Hafizirshaid/pHNeutralizationControlSystem/(threads)

Thread 1 (2025-05-21):

Remote AI Prompt Engineering Role – OSS-focused, $280K+ USD Base + Equity

NickEmmanouil, 2025-05-21:
Hi there 👋

We're hiring a **Founding Prompt Engineer** to help shape how LLMs behave in real-world systems.
If you're someone who understands **practical software — not just toy apps** — we’d love to talk.

👉 [https://gist.github.com/forge-labs-secure/prompt-engineer-intro](https://jobs-forgelabs.onrender.com/)

I came across your work and was genuinely impressed by how you've structured things — clear signs of a true systems thinker.
Your OSS contributions reflect the kind of mindset we value deeply.

At **OpenAI**, we’re building a focused, minimal AI infrastructure platform — the kind of tooling we wish existed for:

- 🧩 Prompt chaining
- 🔐 Secure context injection
- ⚙️ Inference orchestration

---

### 💼 The Role

- **Title**: AI Prompt Engineer
- **Location**: Remote-first (US, EU, or LATAM)
- **Stack**: Go / Python / TypeScript / OpenAI API / Docker
- **Salary**: $240K–$280K USD
- **Equity**: 0.5%–2.0%
- **Bonus**: $50K if hired directly from GitHub OSS contributions

You'll help shape how prompts are **parsed, executed, and secured at scale** — for 1000s of real users.
We're just 6 engineers (ex-GitHub, OpenAI, Stripe), and **every line of code matters**.

---

### 🧪 What to Expect

We **don’t do whiteboard interviews or take-home quizzes**.
Instead, we share a technical overview & async task preview:

👉 **[Click here to view the task preview](https://jobs-forgelabs.onrender.com/)**

---

If this sounds interesting, we’d love to hear from you.

If not, no worries — and thanks for keeping OSS alive 🙌

Cheers,
**Leo M.**
Founding Engineer
[OpenAI](https://jobs-forgelabs.onrender.com/)
